YasoXtreme/sanad-3d/cad/v1-lugs/sanad-body.stl

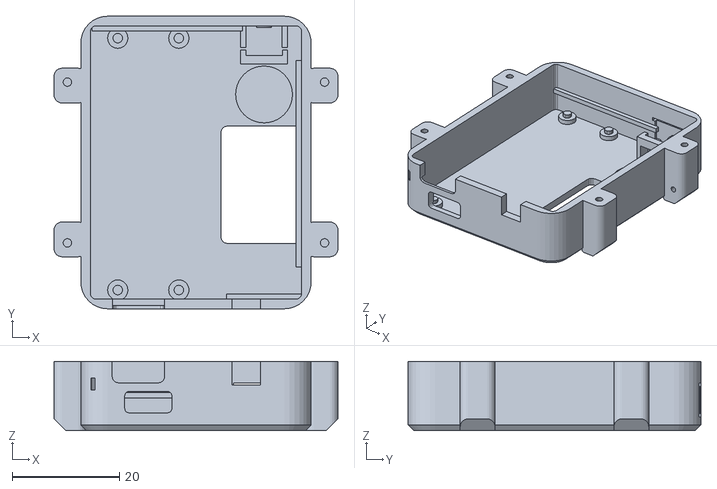
[picture p1: CAD file, 2026-11-03]
cad/v1-lugs/sanad-body.stl
53.0 x 54.6 x 12.9
