YasoXtreme/sanad-3d/models/sanad-lid.stl

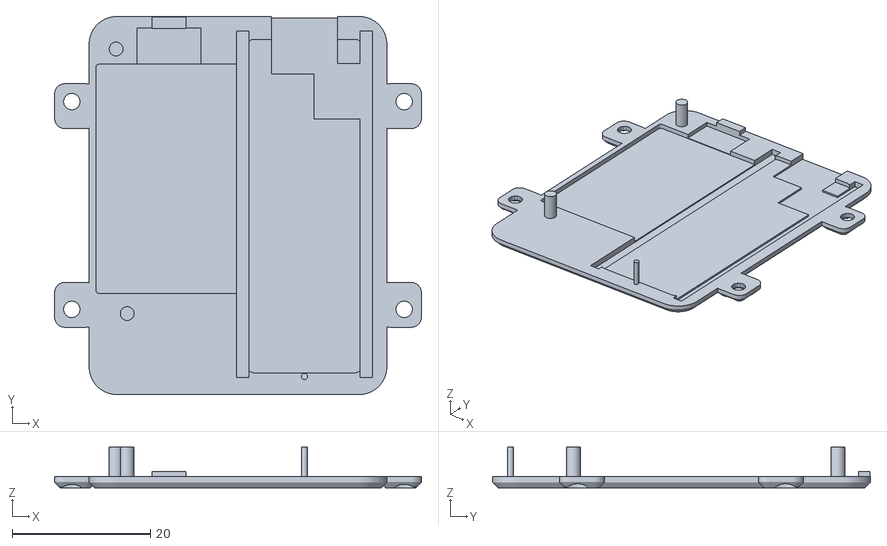
[picture p2: CAD file, 2026-11-04]
models/sanad-lid.stl
53.0 x 54.6 x 5.85
