YasoXtreme/sanad-3d/cad/v1-lugs/sanad-lid.stl

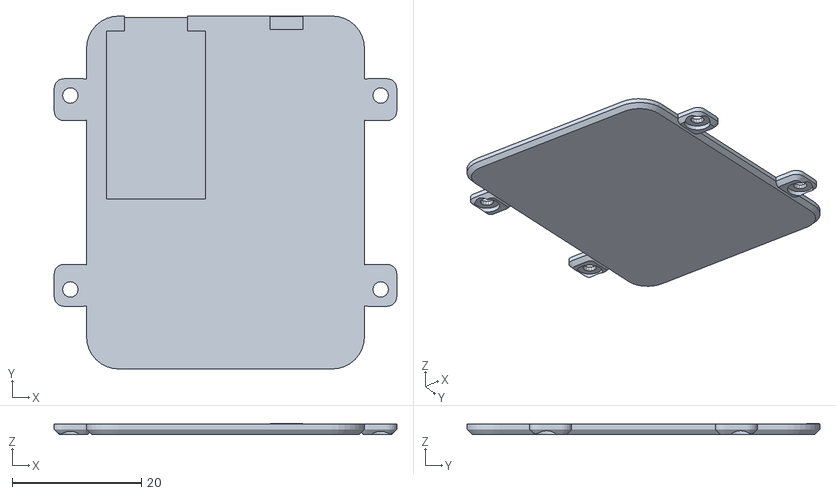
[picture p3: CAD file, 2026-11-03]
cad/v1-lugs/sanad-lid.stl
53.0 x 54.6 x 1.70
