YasoXtreme/sanad-3d/models/sanad-body.stl

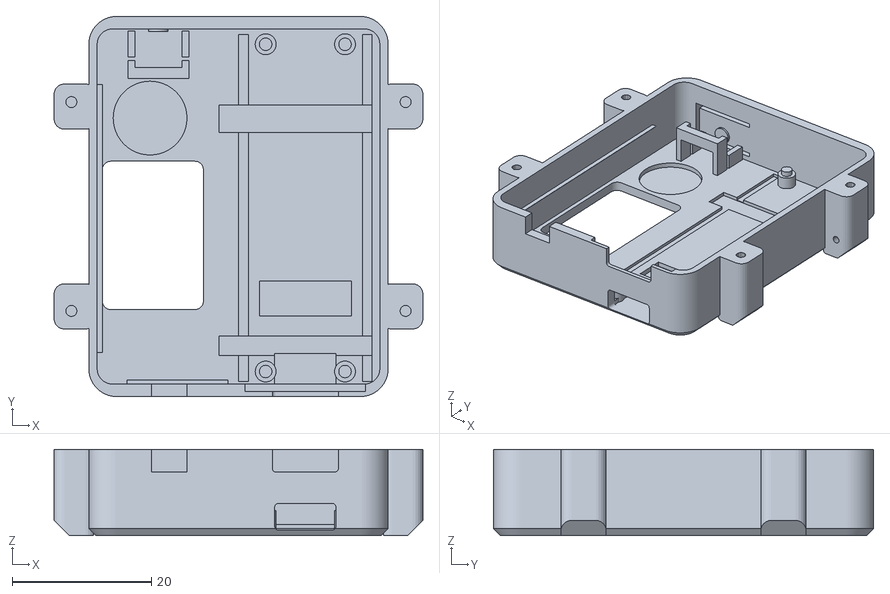
[picture p4: CAD file, 2026-11-04]
models/sanad-body.stl
53.0 x 54.6 x 12.4
