YasoXtreme/sanad-3d/models/sanad-sensor-pad.stl

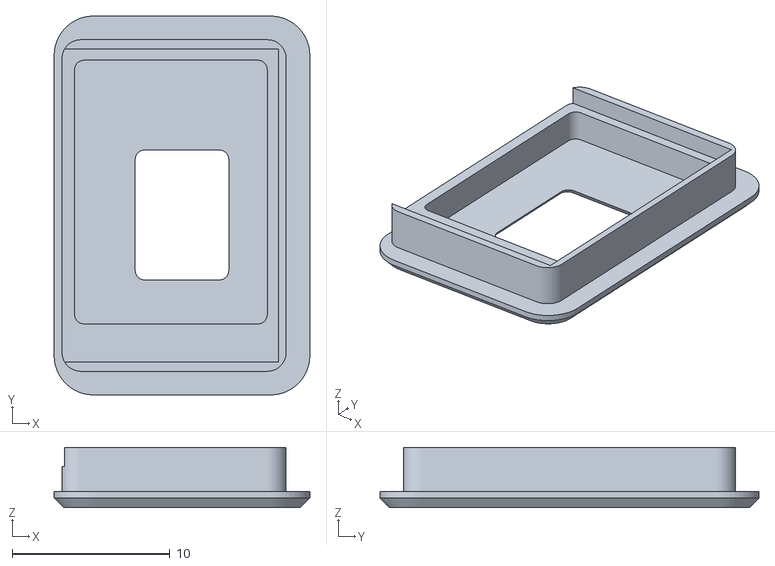
[picture p5: CAD file, 2026-11-04]
models/sanad-sensor-pad.stl
16.2 x 24.0 x 3.80
