YasoXtreme/sanad-3d/models/sanad-tray.stl

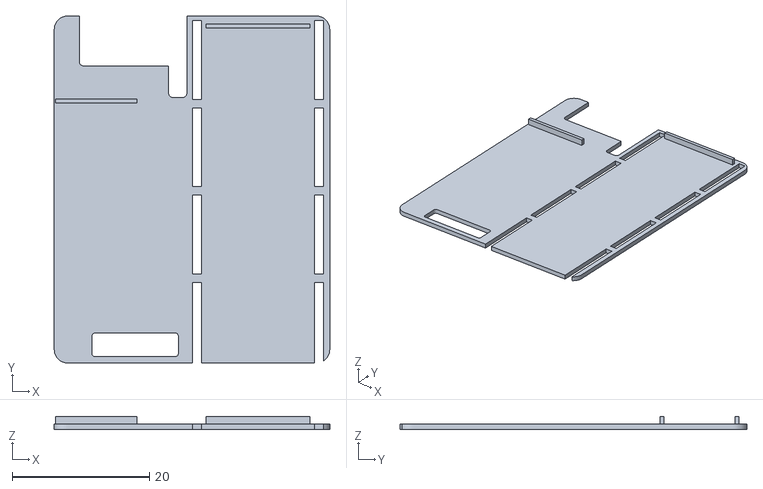
[picture p6: CAD file, 2026-11-04]
models/sanad-tray.stl
40.1 x 50.5 x 1.90
