YasoXtreme/sanad-3d/archive/v2-flipped-pico/print/sanad-v2-sensor-pad.stl

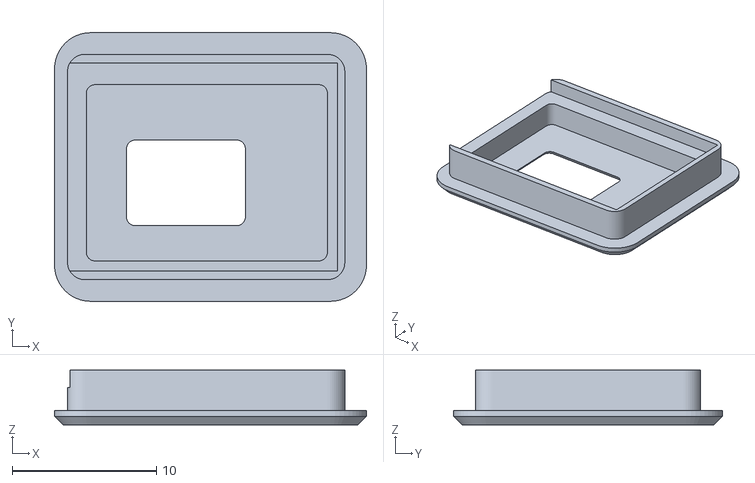
[picture p7: CAD file, 2026-11-04, an earlier design]
archive/v2-flipped-pico/print/sanad-v2-sensor-pad.stl
21.6 x 18.6 x 3.80
