YasoXtreme/sanad-3d/archive/v2-flipped-pico/print/sanad-v2-tray.stl

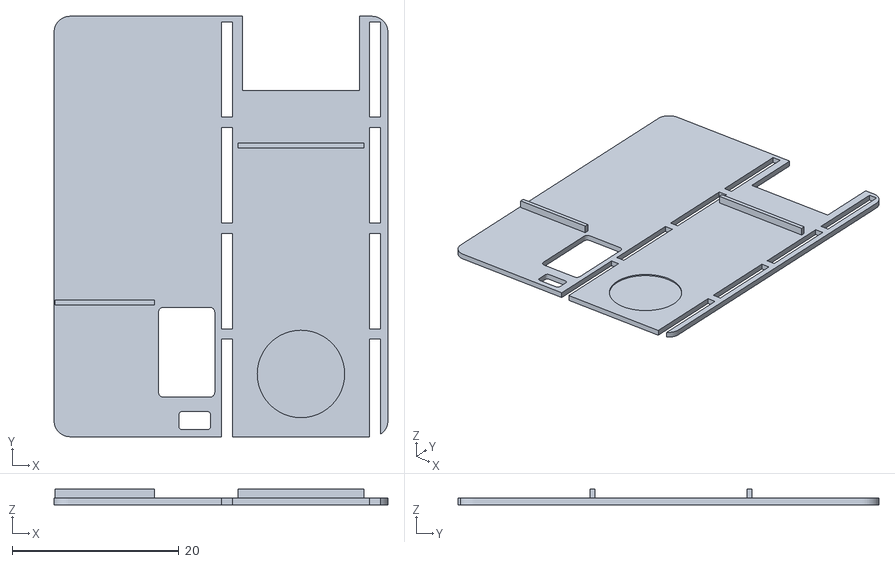
[picture p8: CAD file, 2026-11-04, an earlier design]
archive/v2-flipped-pico/print/sanad-v2-tray.stl
40.1 x 50.5 x 1.90
