YasoXtreme/sanad-3d/archive/v2-flipped-pico/print/sanad-v2-lid.stl

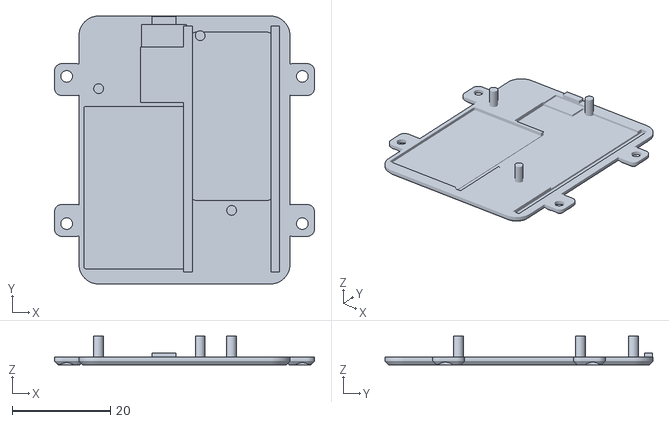
[picture p9: CAD file, 2026-11-04, an earlier design]
archive/v2-flipped-pico/print/sanad-v2-lid.stl
53.0 x 54.6 x 5.90
