YasoXtreme/sanad-3d/archive/v2-flipped-pico/print/sanad-v2-body.stl

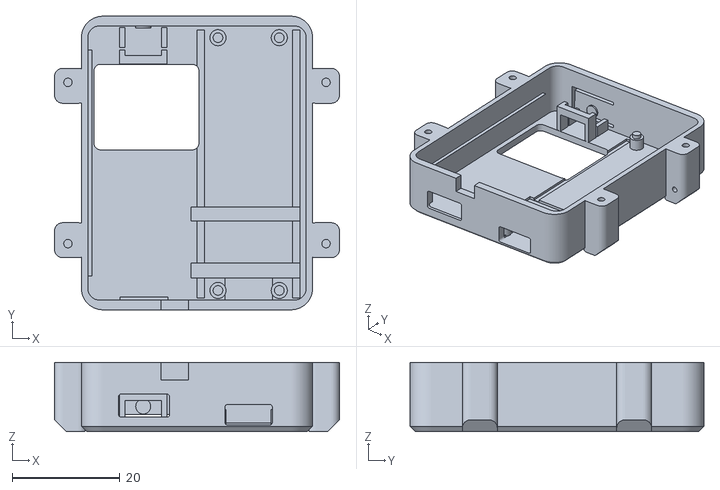
[picture p10: CAD file, 2026-11-04, an earlier design]
archive/v2-flipped-pico/print/sanad-v2-body.stl
53.0 x 54.6 x 12.9
