YasoXtreme/sanad-3d/(commit log)

2026-11-03 Add the Sanad band 3D assembly visualizer
    An animated, step-by-step three.js walkthrough of the band body
    assembly guide (v1, 3 Nov 2026): the four real print STLs put back in
    their assembled positions, stand-ins for every board and part placed
    with a port of the CAD layout, the guide's 12 steps with timed camera
    moves, callouts, wiring, a MicroPython test console, the PROG resistor
    swap, a cross-section through the sensor, and the band on the wrist.
    Claude-Session: https://claude.ai/code/session_01LypYaNqXhEkdjjDxQ7FKzY
    [sanad-body.stl, sanad-lid.stl, sanad-sensor-pad.stl, sanad-tray.stl]
2026-11-03 Add a light/dark mode toggle button
2026-11-04 Switch the assembly guide to the v2b design
    The Pico 2 W now goes in upside-down with every header pin kept, so it
    stays usable in other projects. The layers follow Yassen's notes: Pico,
    MAX30102, motor and button on the floor, then the tray, then TP4056,
    MPU-6050, battery and switch.
    - Replace the four print files with v2b (43.0 x 54.6 x 14.0 mm)
    - Port the layout and the clash-checked wire routes
    - Flip the Pico in Step 5, keep its pins and plastic strips
    - Rewrite the 12 steps; move the PROG resistor swap to Step 8
    - Use the official micro-USB position and the wider MAX30102 estimate
    Not printed yet: the Pico header, MAX30102 board, TP4056 and battery
    sizes are still estimates.
    Co-Auth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
    [sanad-body.stl, sanad-lid.stl, sanad-sensor-pad.stl, sanad-tray.stl]
2026-11-04 Add the v2b CAD, PDF guide and archive of older designs
    Bring the whole v2b design into the repo so it is the one real design:
    - cad/: parametric CAD source, fit checks and wire-route checks. It now
    writes straight to models/ and rebuilds on its own from cad/v1-lugs/
    - docs/: new print and assembly guide for v2b, with figures rendered
    from the real model
    - archive/: the v1 PDF guide, and the first flipped layout as a fallback
    if the TP4056 is too wide to sit between the pin rows
    - README: now covers the whole project, not only the 3D guide
    All checks pass: 0 clashes across 31 parts and 23 wires, the print files
    rebuild byte-identical, and the guide matches the CAD on 62 layout
    values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
    [sanad-body.stl, sanad-lid.stl, sanad-v2-body.stl, sanad-v2-lid.stl, sanad-v2-sensor-pad.stl, sanad-v2-tray.stl]
